leorosie/QSSI-AWS/doc/system overview/overview.odt

# Microcontroller

## Overview:

The microcontroller for this project is an ESP32 chip on a Sparkfun ESP32 Thing version 1.0 development board. Its inputs, outputs, and internal states are controlled through a state pattern. Many of the microcontroller’s features (like I2C, non-volatile storage, and low-power operation) are used. Some features of the microcontroller were not appropriate or adequate for this project and had to be worked around. Further, the development board required physical modifications to meet the needs of the project. More information can be found below and in the `doc/schematic/` and `doc/board\ modifications/` directories.

## State Model:

The software uses a modified gang-of-four (GoF) state pattern where the system’s state is controlled by a PowerState object which is then passed between functions in the application’s core logic. This differs from the original GoF state pattern in that the context is not owned by a particular object, but shared by a few functions. The state may be modified by calling methods of this object which enable and disable power buses, engage and release chip select lines, and change power saving modes in the ESP32 itself. More information can be found in the software documentation.

### Basic State:

Most of the system’s PowerState configurations are based upon its ‘basic state’ where the chip is fully operational but no power buses are engaged nor are any chip select lines engaged. This serves as the basis for most cases where the system is awake. The system states that make use of this state are the SD card access states, the sensor reading states, and the WiFi station state. More information can be found in the `PowerState` software documentation and the `doc/schematic/` directory for hardware details.

#### Sensor Power Bus:

All of the system’s sensors are ‘lifted’ from ground when this bus is not engaged, ensuring they do not draw power except when needed. This is controlled by GPIO pulling up on Q1, and affects the temperature sensor, sonic range sensor, and external ADC.

#### SD Card Power Bus:

The system presently supports two SD cards in the same fashion described for the Sensor Power Bus where each SD card is controlled by pulling up on one of Q2 or Q3.

### Sleep State:

The system spends most of its time asleep, so this state is very important to the project. The PowerState will ensure that all auxiliary power buses and chip selects are disengaged and that the appropriate protocols for waking up are in place before entering this low power state. More information can be found in the `PowerState` software documentation.

## Microcontroller Resources:

Numerous resources provided by the microcontroller and its development board are used by the project. Developers seeking to modify or add to the project must be mindful of existing hardware before they make any changes.

### GPIO:

Numerous general purpose input/output (GPIO) pins are used to switch power rails on and off, act as chip selectors, communicate with sensors through specialized libraries, act as listeners for wake signals, and more. Detailing all of their uses is beyond the scope of this section so the reader is encouraged to examine the software documentation of `pins.h`.

### I2C:

The Inter-integrated circuit (I2C) lines on the microcontroller are used to communicate with a ZS-042 Real Time Clock (RTC) module, which wakes the system from sleep to take readings from sensors. This system is therefor central to the project’s success. More information can be found in the `RTC_container` software documentation.

### SPI:

The Serial Peripheral Interface (SPI) lines on the microcontroller are used to communicate with the external analog to digital converter (ADC) and the Secure Digital (SD) card readers. In addition, several additional GPIO pins are used by this system as chip selector (CS) pins; these CS pins are pulled-down as needed by the PowerState as different SPI systems are connected to power buses.

### NVS:

The ESP32 microcontroller has a section of on-board flash memory that is accessible by software. This Non-volatile Storage (NVS) is used as a temporary storage space for the system so that data collected by sensors need not immediately be sent to SD cards. The energy cost to activate and write to an SD card is non-trivial, so by using NVS to store data for several hours between writes, significant improvements in power consumption are made. More information on this subsystem can be found in the `NVS_container` software documentation.

### WiFi:

The ESP32 microcontroller has a built-in WiFi system that enables both client and station operation. This project enables a WiFi access point station when the WiFi button is used to wake the system; a simple web server then hosts data from the NVS for a client to connect and view. This is a very experimental feature of the project that likely will not be used in the field due to its prohibitive power consumption (even in short uses) but it could conceptually be used to verify the correct operation of the system in the field. Details on this subsystem can be found in the `Wifi_container` software documentation.

### Deep Sleep (power saving modes):

The ESP32 microcontroller is capable of turning off major portions of its circuitry in order to conserve power. This project hinges on such functionality. When in deep sleep, the system’s current consumption has been measured at 85 μA. The system will wake up when it receives a signal from the external RTC or one of the buttons is pressed. The description of these wakeup signals can be found in the `PowerState` enter sleep method.

## ESP32 Issues and workarounds:

### Overview:

The ESP32 is a fairly new contender in the world of microcontrollers and it is very easy to run afoul of its development process. The code is undergoing continuous changes and new chip errata are being uncovered and solved. Some features required for this project couldn’t be obtained from the microcontroller (or needed considerable efforts to use) and documenting these issues may be helpful to future developers in understanding the rationale behind this system’s design and engineering. Specifically, the project required an external ADC, an external RTC, and modifications to the development board.

### On-board ADC:

The ADCs on-board the ESP32 do not have the linear response desired of such devices. While they have improved considerably- even over the short development cycle of this project- they still do not precisely map a range of inputs to a range of outputs in a linear fashion! The fix for this was, as briefly mentioned above, to include an external ADC module. More on this can be found in the `Pyranometer` section below and in the software documentation for the `PyranometerSensor`.

### On-board RTC:

The RTC built in to the ESP32 is not sufficiently accurate for this project. The currently-supported 150 kHz on-board crystal may drift by up to 10% of value and any on-board RTC may require additional circuitry to remain powered on in deep sleep (see https://forum.pycom.io/topic/1069/accuracy-of-rtc for more information). Therefor, the simplest answer is to offload this work to an external RTC with known accuracy and power consumption like the DS3231 integrated circuit on board the ZS-042 module. Details on the use of this module can be found in the `RTC_container` software documentation.

### Development Board Errata:

The Sparkfun ESP32 Thing development board is not prepared to capitalize on the full benefits of deep sleep by default. By referencing an ESP32 forum, the development board was successfully modified to reach a more agreeable power consumption. Details on the exact changes made and a link to this forum post may be found in `doc/board\ modifications`.

## Wiring:

A full schematic of the project can be found in the `doc/schematic/` directory and a simple diagram showing the wiring of sensors inside the enclosure to the prototype board is included as well.

# Sensors:

## Overview:

The microcontroller contains three different sensors: Matix DS1820B temperature sensor, HRXL-MaxSonar-WRS Ultrasonic Snow Depth Sensor, and Apogee SP-110 pyranometer. Frost remains a large source of error for all devices. The pyranometer and ultrasonic sensor are mounted on a 1 meter arm away from the mounting equipment. Electronic housing is vital for all sensors.

## Temperature Sensor:

The DS1820B works using two bandgap-generated voltage sources. One voltage changes across temperature while the other voltage has a low-temperature coefficient and does not change. An ADC then converts the difference of the voltages using a dual-oscillator topology. The temperature sensor communicates to the ESP32 via 1-Wire bus. A pull up resistor is required of approximately 5 kilo ohms. The sensor requires a 3.3 V supply which draws a 1.5 mA current. It is vital for the temperature sensor to be enclosed in housing in order to protect it from solar radiation and wind. The DS1820B operates to a temperature as low as -55 C. The 1-Wire protocol uses a single bus master to control the DS1820B slave. Since there is only one temperature sensor in the unit this system is referred to as a “single-drop” system. Data is transmitted least significant bit via 1-Wire.

## Ultrasonic Sensor:

The ultrasonic rangers measures distance which can be used to calculate the accumulation rate of the Greenland Ice Sheet. The sensor uses a high frequency sound to measure the time for the sound to be transmitted and reflected back. The ESP32 then reads a pulse width outputted by the sensor which represents the distance with a scale factor of 1 uS per mm. The sensor needs a 3.3 V supply which draws 2.3 mA of current. This sensor is specifically built to be used in cold and snowy conditions. The sensor must be mounted away from any objects or large towers, therefore the sonic ranger has been mounted on an arm that is approximately 1 meter away from the mounting equipment. It is also important for the sonic ranger to remain level and be at least 1 meter off the ground in order to supply accurate readings. Other potential sources of error are frost and blowing snow.

## Pyranometer:

The pyranometer measures global shortwave solar radiation. The SP-110 uses a silicon cell detector. This is built around a silicon photodetector which produces a current proportional to the amount of sunlight. A load resistor is required to measure the flow of electrons which is proportional to the sunlight falling on the detector. This is proportional to Ohms law. This pyranometer has a mV range of 0-350 but is only sensitive to 350-1100 nm of the solar spectrum (approximately 80% of the total shortwave radiation). It is self powered and can work to as low as -40 C and can be submerged in water up to depths of 30 m. The measured mV signal must be multipled by a calibration factor of 5.0 W m⁻² per mV in order to obtain the shortwave radiation in W m⁻². The ESP32 has a nonlinear ADC therefore an external ADC was needed. Additionally, due to the low voltage range outputted by the pyranometer an operational amplifer is needed in order to read the signal. This is attached on a daughter board to the pyranometer. The MCP3004 is used as the external ADC and the lm324n is used as the operational amplifier. A drawback to the lm324n is that it only operates to temperatures as low as 0 C. The operational amplifier also adds a gain to the noise, therefore a steady reading is seen even when there is no solar radiation present, this is accounted for in the code. The pyranometer can read as a differential voltage or single voltage, here the differential voltage is used on the operational amplifier and single voltage is used on the external ADC. A reference voltage of 3.3 V was used in order to account for nonlinearity seen in lower reference voltages. The drawbacks of the higher reference voltage is a larger range in outputs for small differences. The pyranometer must be level and oriented with the cable pointing to true north when in use. The SP-110 contains a level on the sensor. Cloudy skies can increase errors by approximately 9.6% due to the fact the sensor was calibrated in clear sky conditions. It should be noted that the current system of measurement needs to be extensively tested more in order to ensure that readings are accurate.

# Connectivity:

## Overview:

This project has built in Wi-fi that allows the user to quickly identify the last measurements from each sensor to ensure the system is working. Due to the final use of the project this connectivity will not be used in the field.

## Wi-fi Connectivity:

The purpose of the connectivity addition is to provide proof to the user that the microcontroller is working and taking reasonable measurements. A built in button may be pressed which wakes up the station and creates a wi-fi hot spot that a user can connect to and navigate to the following IP address: 192.168.4.1. The ssid is “QSSI-AWS” and the password is “12345678”. The user will then see on their smart device each reading that was last taken from the NVS as well as the current time. The drawbacks include that the wi-fi requires an external power supply in order to work sufficiently therefore this function will not be used in the field. More information can be found in the software documentation.

# System Errata:

### Overview:

The system still has a few outstanding issues which could not be resolved to satisfaction in the available time. Some of these issues are not significant in the normal operation of the system but should be kept in consideration by future developers of the project. The known issues are as follows:

### RTC draws more power than needed:

The external RTC is presently connected to the system’s power rails. In the original specification, the RTC would be self-powered by its on-board button cell battery. This does not work because the Sparkfun ESP32 Thing does not pull-up on the I2C lines while it is in deep sleep. There are two practical solutions to this problem:

1. Install pull up resistors on the SCL and SDA lines to the external RTC, cut the VCC line to the external RTC, and install its button cell battery. Values between 4k7 and 10k ohms should prove adequate.
2. Modify the ZS-042 external RTC module to reduce power consumption. This involves disconnecting its and possible modification of its power circuitry.

### Dual/multi SD card operation is disabled:

For purposes of testing, only one SD card is currently supported. It was necessary to remove the previous two SD card readers due to faulty operation on the SPI lines and install another, more friendly unit. This unit is also not ideal due to its operation without level-shifting functionality. To resolve these issues, the developers should:

1. Remove the current SD card module.
2. Install the new SD card modules (Sparkfun level-shifting microSD card readers) using the provided buses. Mechanical support should be taken into account in this process.
3. Re-enable the second SD card module in the system’s software. The necessary calls can be found in the `main.cpp` software documentation.

### Pyranometer output scaling needs verification:

At present, the pyranometer output should not be trusted to accurately relate the perceived intensity of shortwave radiation in its prescribed units of W/m². In addition to uncertainty in the accuracy of the instrument, the circuitry which amplifies and digitizes the output (operational amplifier and ADC) should be scrutinized before field deployment. Further, it would be beneficial to switch to using the ESP32’s on-board ADC as soon as the performance of the unit is fixed by patch to firmware (e.t.a. unknown; check with esp32-idf developer releases for more information). To resolve these issues, the developers should:

1. Send a preferred pyranometer to its manufacturer for calibration and testing.
2. Verify that the calibrated pyranometer delivers the expected output (0V in darkness, 0.25V at solar zenith in summer; results may significantly vary so this is important).
3. Test the operational amplifier’s output voltage for faithful amplification of the pyranometer’s signal from 0~25 mV to 0~325 mV.
4. Verify the ADC’s conversion of the amplified signal from 0~325 mV to 0~1023 (dimensionless integer).

### Wi-fi requires external power supply:

Current use of the wi-fi enabled button requires use of an external power supply in order to efficiently work with the ESP32. Therefore this function will not be used in the field due to power limitations.

### Camera is not ready for installation:

An optional (but encouraged) aspect of this system is a time-lapse camera to take daily snapshots of the system’s environment. At the time of this document’s writing the camera is not assembled nor is its software contained in the project’s repository.

There are several possible ways for this subsystem to interact with existing modules but likely the easiest solution is for the external RTC to send a daily wakeup signal to the system which interprets the signal to engage the self-contained camera module. This reduces the risk of the (non-critical) camera module causing failure in the primary system.
