leorosie/QSSI-AWS/doc/system overview/flowchart.png

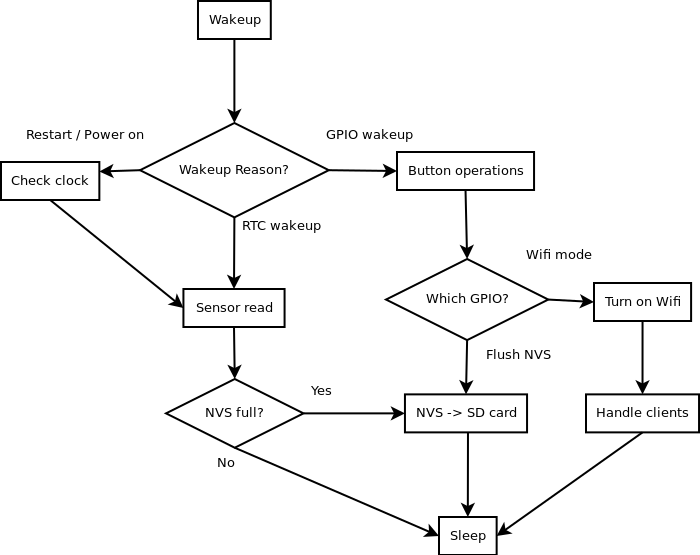
doc/system overview/flowchart.png
