leorosie/QSSI-AWS/doc/schematic/wiring_and_buttons.pdf

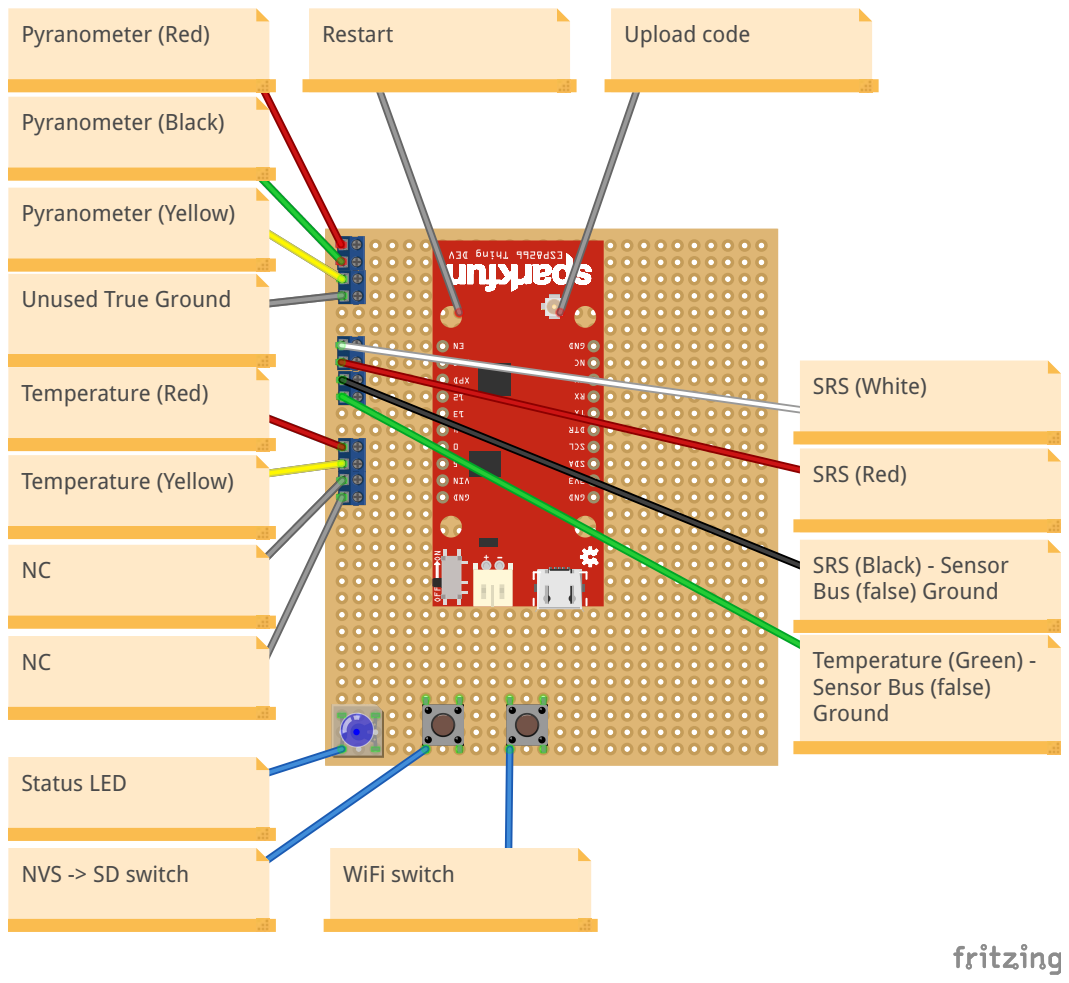
[picture p4: page 1]
Pyranometer (Yellow); Pyranometer (Red); Pyranometer (Black); SRS (White); SRS (Red); Temperature (Red); Temperature (Yellow); Status LED; NVS -> SD switch; WiFi switch; Restart; Upload code

Unused True Ground

SRS (Black) - Sensor
Bus (false) Ground

Temperature (Green) -
Sensor Bus (false)
Ground
