leorosie/QSSI-AWS/doc/schematic/schematic_121217.pdf

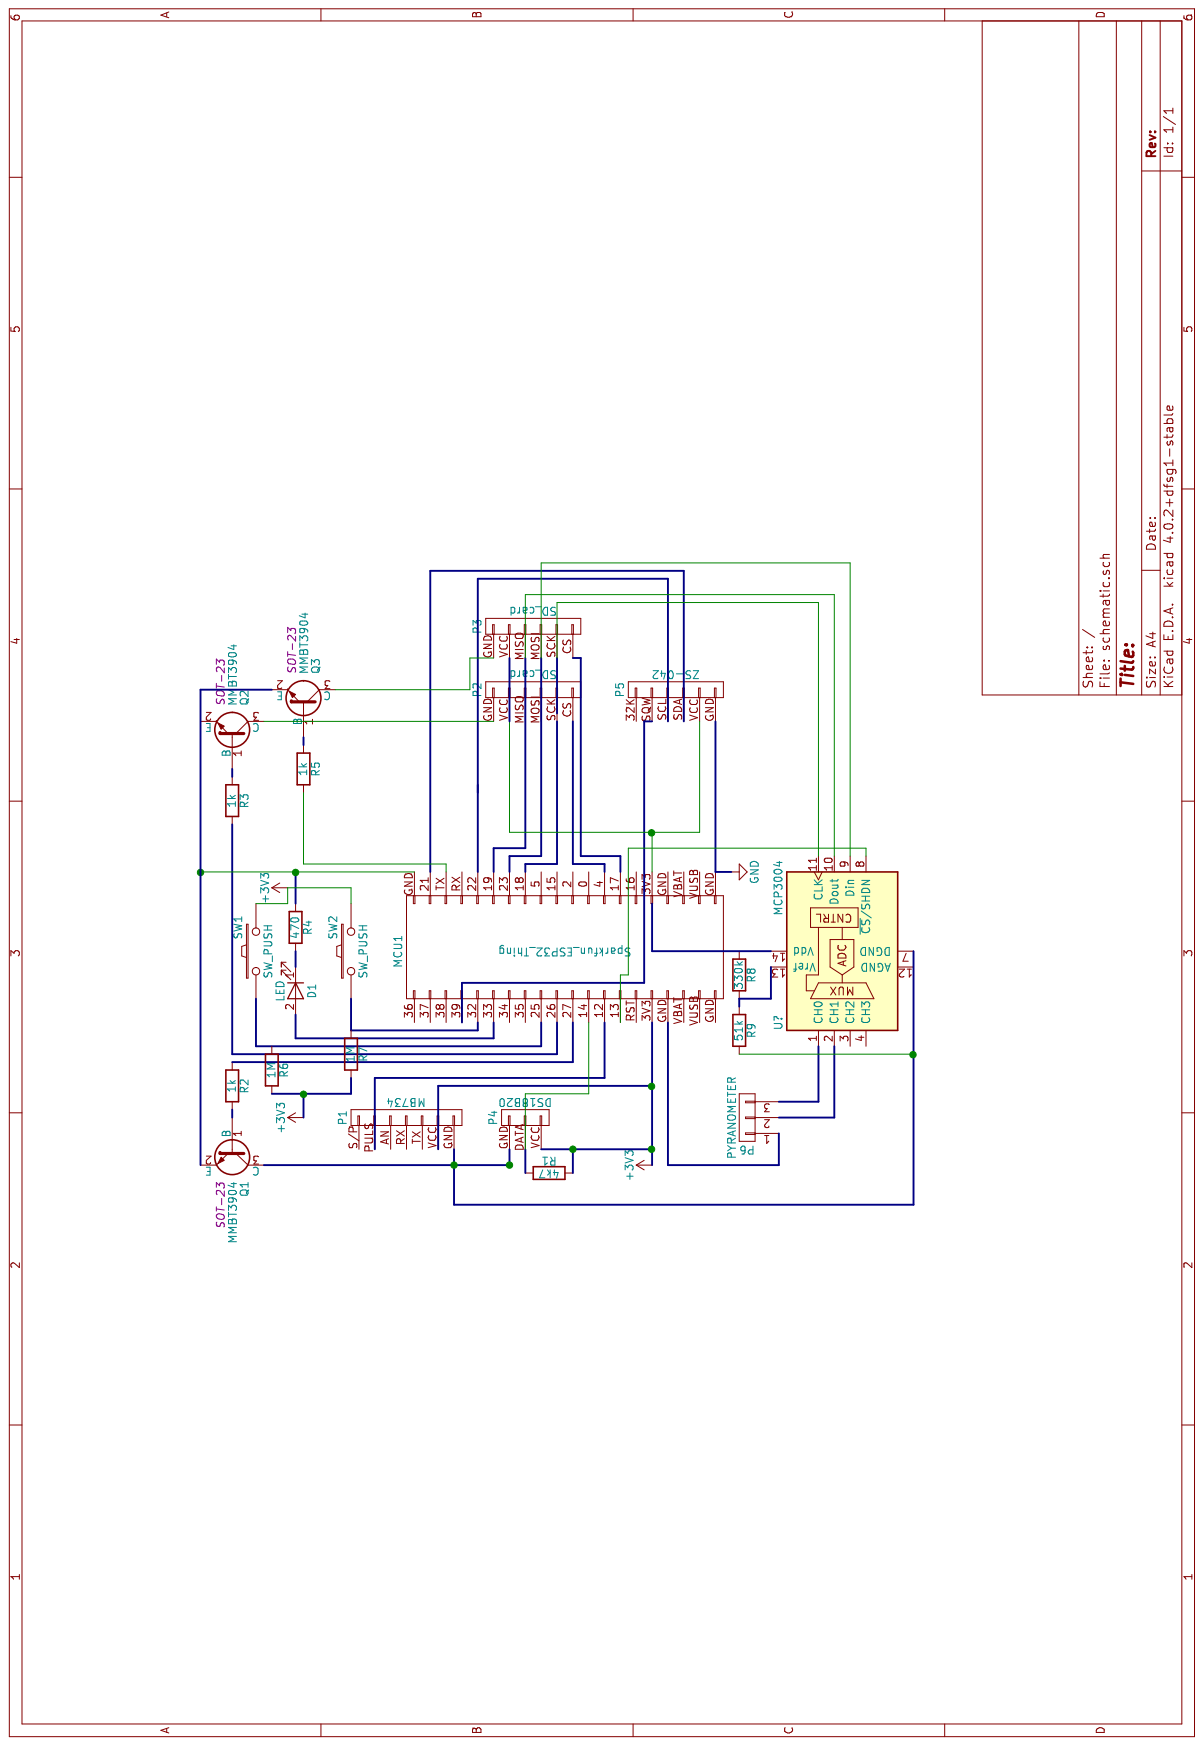
[picture p5: page 1]
