leorosie/QSSI-AWS/doc/schematic/schematic.kicad_pcb

## KiCad design dsky/alarm_indicator/alarm_indicator.kicad_pcb

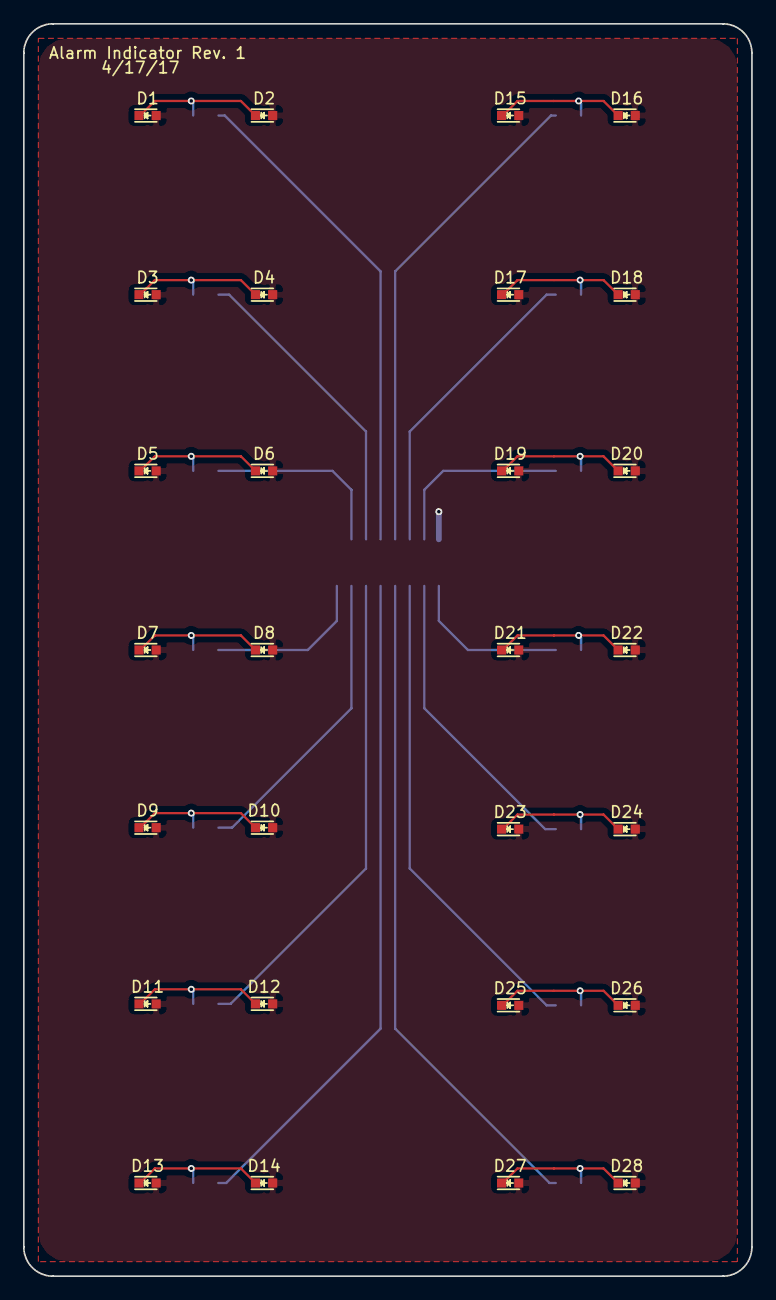
[picture p7: board alarm_indicator.kicad_pcb from above]

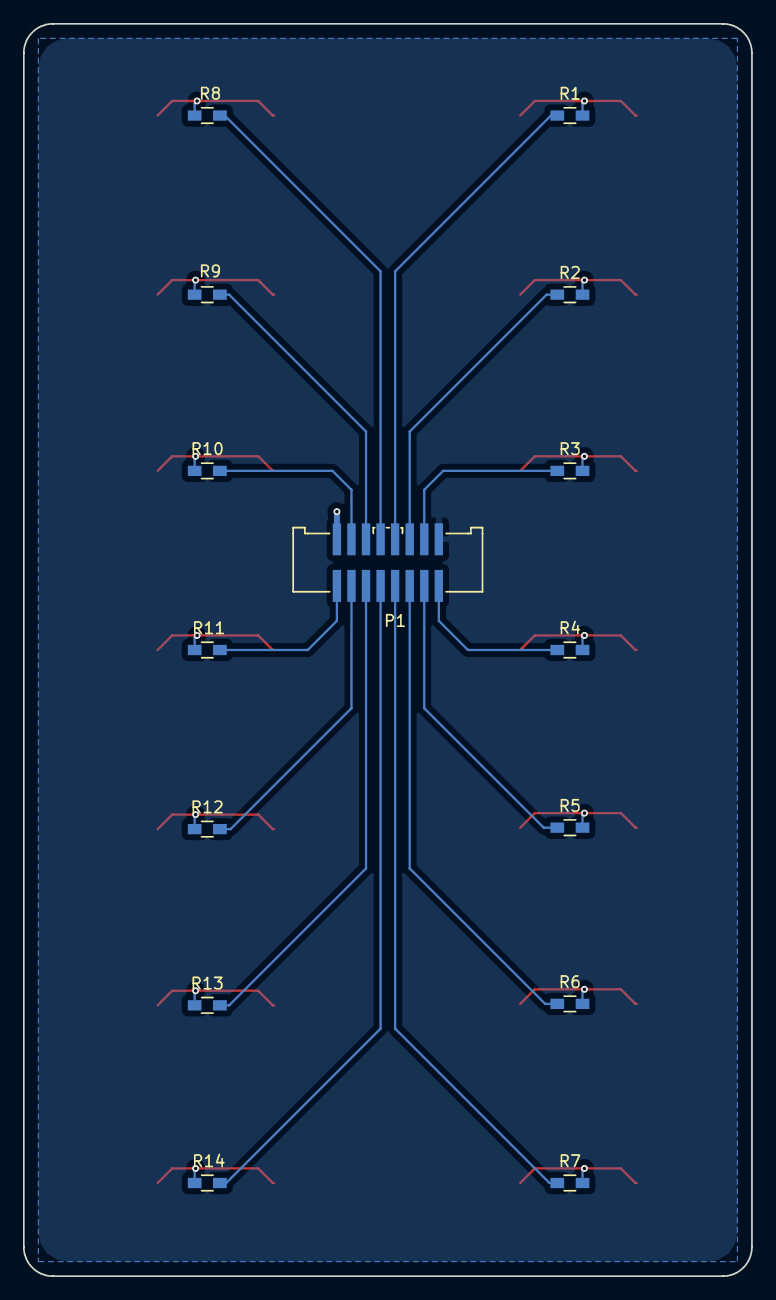
[picture p8: board alarm_indicator.kicad_pcb from below]

Board: 2 copper layers, 63.5 x 109.2 mm, 43 parts (15 on the bottom side), 29 nets.

Parts:
D1, D2, D3, D4, D5, D6, D7, D8, D9, D10, D11, D12, D13, D14, D15, D16, D17, D18, D19, D20, D21, D22, D23, D24, D25, D26, D27, D28: LED; LED-0603
P1: CONN_02X08; SHF-108-01-L-D-SM
R1, R2, R3, R4, R5, R6, R7, R8, R9, R10, R11, R12, R13, R14: 500; R_0603_HandSoldering

Connections:
+12V: D1.2, D2.2, D3.2, D4.2, D5.2, D6.2, D7.2, D8.2, D9.2, D10.2, D11.2, D12.2, D13.2, D14.2, D15.2, D16.2, D17.2, D18.2, D19.2, D20.2, D21.2, D22.2, D23.2, D24.2, D25.2, D26.2, D27.2, D28.2, P1.2
ALT: P1.5, R13.1
GIMBAL_LOCK: P1.6, R9.1
KEY_REL: P1.15, R4.1
NO_ATT: P1.12, R2.1
NO_DAP: P1.9, R7.1
unnamed: D1.1, D2.1, R1.2
unnamed: D3.1, D4.1, R2.2
unnamed: D5.1, D6.1, R3.2
unnamed: D7.1, D8.1, R4.2
unnamed: D9.1, D10.1, R5.2
unnamed: D11.1, D12.1, R6.2
unnamed: D13.1, D14.1, R7.2
unnamed: D15.1, D16.1, R8.2
unnamed: D17.1, D18.1, R9.2
unnamed: D19.1, D20.1, R10.2
unnamed: D21.1, D22.1, R11.2
unnamed: D23.1, D24.1, R12.2
unnamed: D25.1, D26.1, R13.2
unnamed: D27.1, D28.1, R14.2
OPR_ERR: P1.13, R5.1
PRIO_DISP: P1.11, R6.1
PROG: P1.4, R10.1
RESTART: P1.1, R11.1
STBY: P1.14, R3.1
TEMP: P1.8, R8.1
TRACKER: P1.3, R12.1
UPLINK_ACTY: P1.10, R1.1
VEL: P1.7, R14.1
