leorosie/QSSI-AWS/doc/schematic/schematic.kicad_pcb

## KiCad design dsky/digital_indicator/digital_indicator.kicad_pcb

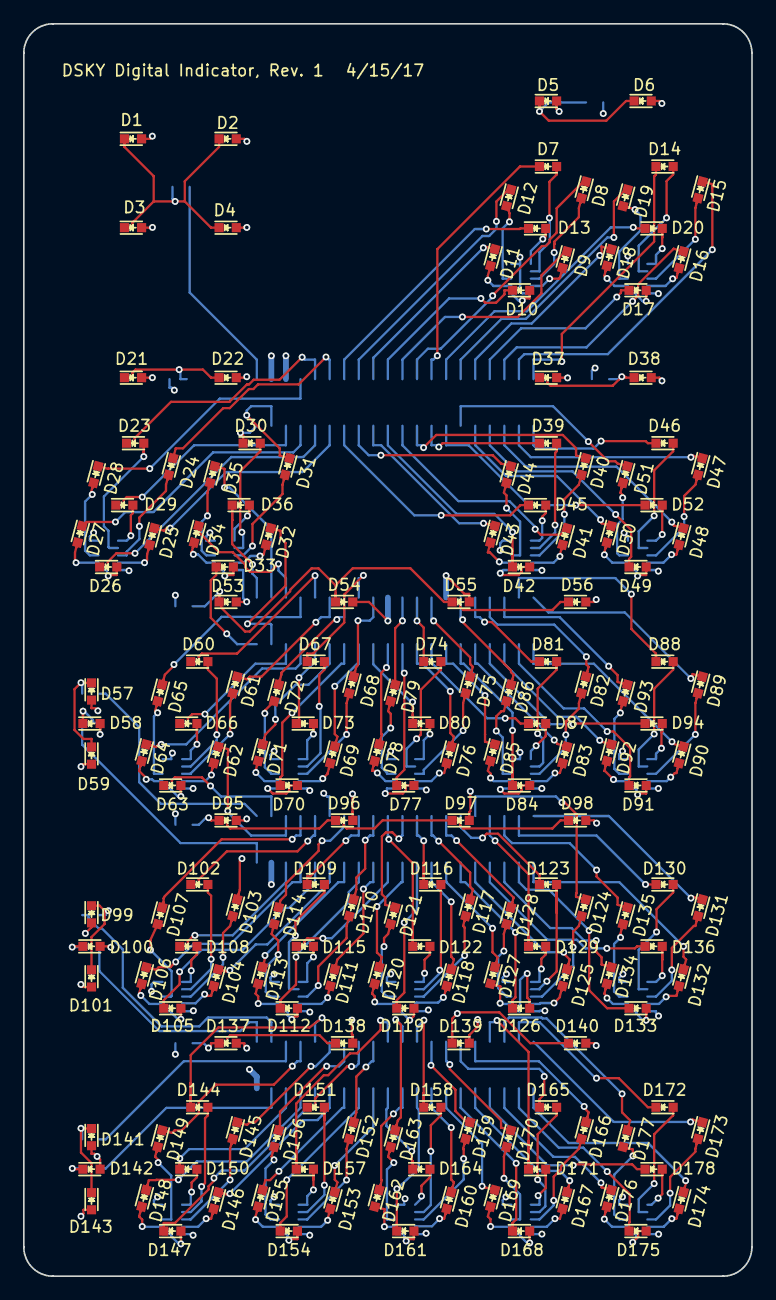
[picture p9: board digital_indicator.kicad_pcb from above]

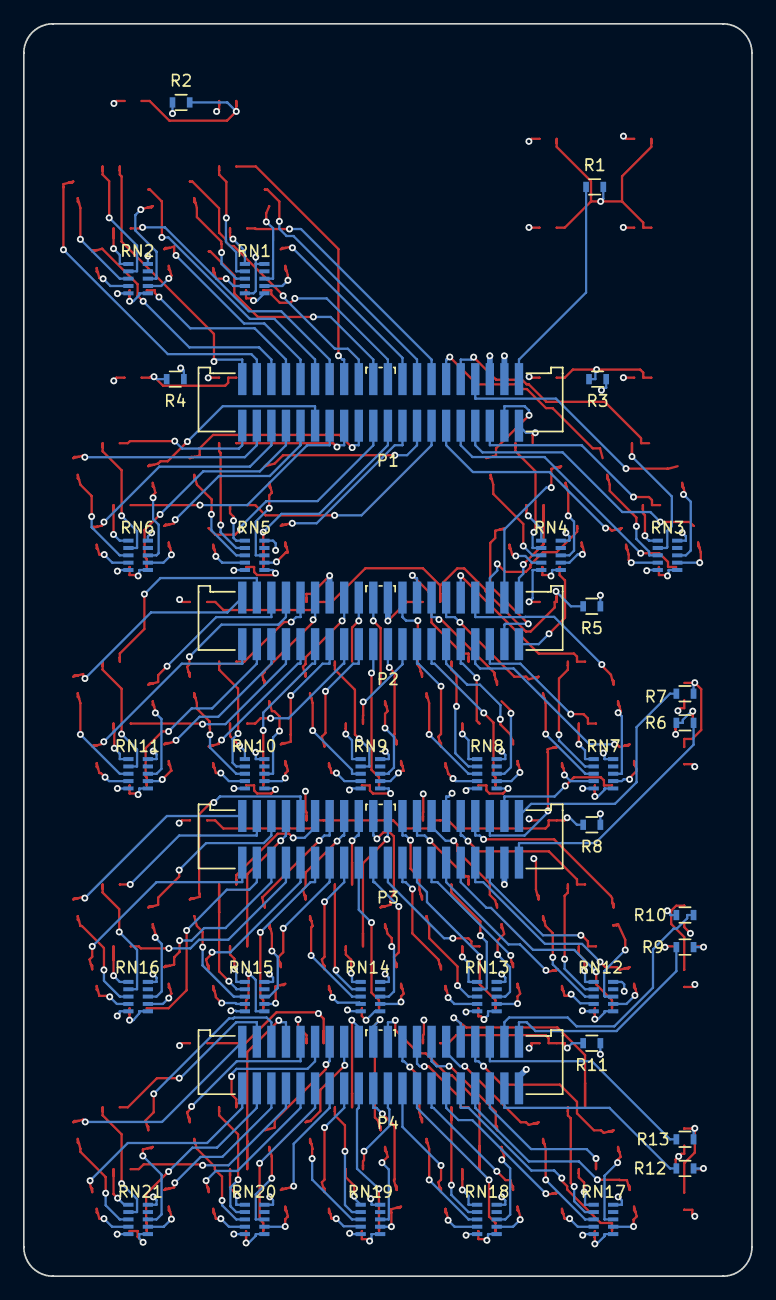
[picture p10: board digital_indicator.kicad_pcb from below]

Board: 4 copper layers, 63.5 x 109.2 mm, 217 parts (38 on the bottom side), 316 nets.

Parts:
D1, D2, D3, D4, D5, D6, D7, D8, D9, D10, D11, D12, D13, D14, D15, D16, D17, D18, D19, D20, D21, D22, D23, D24, D25, D26, D27, D28, D29, D30, D31, D32, D33, D34, D35, D36, D37, D38, D39, D40, D41, D42, D43, D44, D45, D46, D47, D48, D49, D50, D51, D52, D53, D54, D55, D56, D57, D58, D59, D60, D61, D62, D63, D64, D65, D66, D67, D68, D69, D70, D71, D72, D73, D74, D75, D76, D77, D78, D79, D80, D81, D82, D83, D84, D85, D86, D87, D88, D89, D90, D91, D92, D93, D94, D95, D96, D97, D98, D99, D100, D101, D102, D103, D104, D105, D106, D107, D108, D109, D110, D111, D112, D113, D114, D115, D116, D117, D118, D119, D120, D121, D122, D123, D124, D125, D126, D127, D128, D129, D130, D131, D132, D133, D134, D135, D136, D137, D138, D139, D140, D141, D142, D143, D144, D145, D146, D147, D148, D149, D150, D151, D152, D153, D154, D155, D156, D157, D158, D159, D160, D161, D162, D163, D164, D165, D166, D167, D168, D169, D170, D171, D172, D173, D174, D175, D176, D177, D178: LED; LED-0603
G1: LOGO; digital_indicator_outlines
P1, P2, P3, P4: CONN_02X20; SHF-120-01-L-D-SM
R1, R5, R8, R11: 250; R_0603
R2, R3, R4, R7, R10, R13: 500; R_0603
R6, R9, R12: 1k; R_0603
RN1, RN2, RN3, RN4, RN5, RN6, RN7, RN8, RN9, RN10, RN11, RN12, RN13, RN14, RN15, RN16, RN17, RN18, RN19, RN20, RN21: R8_BUSSED; R8_746

Connections:
+12V: D1.2, D2.2, D3.2, D4.2, D5.2, D6.2, D21.2, D22.2, D37.2, D38.2, D53.2, D54.2, D55.2, D56.2, D57.2, D58.2, D59.2, D95.2, D96.2, D97.2, D98.2, D99.2, D100.2, D101.2, D137.2, D138.2, D139.2, D140.2, D141.2, D142.2, D143.2, P1.36, P2.14, P2.22, P3.37, RN1.5, RN1.10, RN2.5, RN2.10, RN3.5, RN3.10, RN4.5, RN4.10, RN5.5, RN5.10, RN6.5, RN6.10, RN7.5, RN7.10, RN8.5, RN8.10, RN9.5, RN9.10, RN10.5, RN10.10, RN11.5, RN11.10, RN12.5, RN12.10, RN13.5, RN13.10, RN14.5, RN14.10, RN15.5, RN15.10, RN16.5, RN16.10, RN17.5, RN17.10, RN18.5, RN18.10, RN19.5, RN19.10, RN20.5, RN20.10, RN21.5, RN21.10
COMACT: P1.40, R1.1
GND: P1.38, P4.39, R2.1, R3.1, R4.1, R5.1, R8.1, R11.1
MD1_A: D7.1, P1.16
MD1_B: D8.1, P1.18
MD1_C: D9.1, P1.20
MD1_D: D10.1, P1.22
MD1_E: D11.1, P1.24
MD1_F: D12.1, P1.26
MD1_G: D13.1, P1.28
MD2_A: D14.1, P1.2
MD2_B: D15.1, P1.4
MD2_C: D16.1, P1.6
MD2_D: D17.1, P1.8
MD2_E: D18.1, P1.10
MD2_F: D19.1, P1.12
MD2_G: D20.1, P1.14
ND1_A: D39.1, P1.15
ND1_B: D40.1, P1.17
ND1_C: D41.1, P1.19
ND1_D: D42.1, P1.21
ND1_E: D43.1, P1.23
ND1_F: D44.1, P1.25
ND1_G: D45.1, P1.27
ND2_A: D46.1, P1.1
ND2_B: D47.1, P1.3
ND2_C: D48.1, P1.5
ND2_D: D49.1, P1.7
ND2_E: D50.1, P1.9
ND2_F: D51.1, P1.11
ND2_G: D52.1, P1.13
unnamed: D1.1, D2.1, D3.1, D4.1, R1.2
unnamed: D5.1, D6.1, R2.2
unnamed: D7.2, RN1.2
unnamed: D8.2, RN1.3
unnamed: D9.2, RN1.4
unnamed: D10.2, RN1.6
unnamed: D11.2, RN1.7
unnamed: D12.2, RN1.8
unnamed: D13.2, RN1.1
unnamed: D14.2, RN2.2
unnamed: D15.2, RN2.3
unnamed: D16.2, RN2.4
unnamed: D17.2, RN2.6
unnamed: D18.2, RN2.7
unnamed: D19.2, RN2.8
unnamed: D20.2, RN2.1
unnamed: D21.1, D22.1, R3.2
unnamed: D23.2, RN3.2
unnamed: D24.2, RN3.3
unnamed: D25.2, RN3.4
unnamed: D26.2, RN3.6
unnamed: D27.2, RN3.7
unnamed: D28.2, RN3.8
unnamed: D29.2, RN3.1
unnamed: D30.2, RN4.2
unnamed: D31.2, RN4.3
unnamed: D32.2, RN4.4
unnamed: D33.2, RN4.6
unnamed: D34.2, RN4.7
unnamed: D35.2, RN4.8
unnamed: D36.2, RN4.1
unnamed: D37.1, D38.1, R4.2
unnamed: D39.2, RN5.2
unnamed: D40.2, RN5.3
unnamed: D41.2, RN5.4
unnamed: D42.2, RN5.6
unnamed: D43.2, RN5.7
unnamed: D44.2, RN5.8
unnamed: D45.2, RN5.1
unnamed: D46.2, RN6.2
unnamed: D47.2, RN6.3
unnamed: D48.2, RN6.4
unnamed: D49.2, RN6.6
unnamed: D50.2, RN6.7
unnamed: D51.2, RN6.8
unnamed: D52.2, RN6.1
unnamed: D53.1, D54.1, D55.1, D56.1, R5.2
unnamed: D57.1, D59.1, R7.1
unnamed: D58.1, R6.1
unnamed: D60.2, RN7.2
unnamed: D61.2, RN7.3
unnamed: D62.2, RN7.4
unnamed: D63.2, RN7.6
unnamed: D64.2, RN7.7
unnamed: D65.2, RN7.8
unnamed: D66.2, RN7.1
unnamed: D67.2, RN8.2
unnamed: D68.2, RN8.3
unnamed: D69.2, RN8.4
unnamed: D70.2, RN8.6
unnamed: D71.2, RN8.7
unnamed: D72.2, RN8.8
unnamed: D73.2, RN8.1
unnamed: D74.2, RN9.2
unnamed: D75.2, RN9.3
unnamed: D76.2, RN9.4
unnamed: D77.2, RN9.6
unnamed: D78.2, RN9.7
unnamed: D79.2, RN9.8
unnamed: D80.2, RN9.1
unnamed: D81.2, RN10.2
unnamed: D82.2, RN10.3
unnamed: D83.2, RN10.4
unnamed: D84.2, RN10.6
unnamed: D85.2, RN10.7
unnamed: D86.2, RN10.8
unnamed: D87.2, RN10.1
unnamed: D88.2, RN11.2
unnamed: D89.2, RN11.3
unnamed: D90.2, RN11.4
unnamed: D91.2, RN11.6
unnamed: D92.2, RN11.7
unnamed: D93.2, RN11.8
unnamed: D94.2, RN11.1
unnamed: D95.1, D96.1, D97.1, D98.1, R8.2
unnamed: D100.1, R9.1
unnamed: D99.1, D101.1, R10.1
unnamed: D102.2, RN12.2
unnamed: D103.2, RN12.3
unnamed: D104.2, RN12.4
unnamed: D105.2, RN12.6
unnamed: D106.2, RN12.7
unnamed: D107.2, RN12.8
unnamed: D108.2, RN12.1
unnamed: D109.2, RN13.2
unnamed: D110.2, RN13.3
unnamed: D111.2, RN13.4
unnamed: D112.2, RN13.6
unnamed: D113.2, RN13.7
unnamed: D114.2, RN13.8
unnamed: D115.2, RN13.1
unnamed: D116.2, RN14.2
unnamed: D117.2, RN14.3
unnamed: D118.2, RN14.4
unnamed: D119.2, RN14.6
unnamed: D120.2, RN14.7
unnamed: D121.2, RN14.8
unnamed: D122.2, RN14.1
unnamed: D123.2, RN15.2
unnamed: D124.2, RN15.3
unnamed: D125.2, RN15.4
unnamed: D126.2, RN15.6
unnamed: D127.2, RN15.7
unnamed: D128.2, RN15.8
unnamed: D129.2, RN15.1
unnamed: D130.2, RN16.2
unnamed: D131.2, RN16.3
unnamed: D132.2, RN16.4
unnamed: D133.2, RN16.6
unnamed: D134.2, RN16.7
unnamed: D135.2, RN16.8
unnamed: D136.2, RN16.1
unnamed: D137.1, D138.1, D139.1, D140.1, R11.2
unnamed: D141.1, D143.1, R13.1
unnamed: D142.1, R12.1
unnamed: D144.2, RN17.2
unnamed: D145.2, RN17.3
unnamed: D146.2, RN17.4
unnamed: D147.2, RN17.6
unnamed: D148.2, RN17.7
unnamed: D149.2, RN17.8
unnamed: D150.2, RN17.1
unnamed: D151.2, RN18.2
unnamed: D152.2, RN18.3
unnamed: D153.2, RN18.4
unnamed: D154.2, RN18.6
unnamed: D155.2, RN18.7
unnamed: D156.2, RN18.8
unnamed: D157.2, RN18.1
unnamed: D158.2, RN19.2
unnamed: D159.2, RN19.3
unnamed: D160.2, RN19.4
unnamed: D161.2, RN19.6
unnamed: D162.2, RN19.7
unnamed: D163.2, RN19.8
unnamed: D164.2, RN19.1
unnamed: D165.2, RN20.2
unnamed: D166.2, RN20.3
unnamed: D167.2, RN20.4
unnamed: D168.2, RN20.6
unnamed: D169.2, RN20.7
unnamed: D170.2, RN20.8
unnamed: D171.2, RN20.1
unnamed: D172.2, RN21.2
unnamed: D173.2, RN21.3
unnamed: D174.2, RN21.4
unnamed: D175.2, RN21.6
unnamed: D176.2, RN21.7
unnamed: D177.2, RN21.8
unnamed: D178.2, RN21.1
R1+: P3.40, R7.2
R1-: P3.39, R6.2
R1D1_A: D60.1, P2.32
R1D1_B: D61.1, P2.30
R1D1_C: D62.1, P3.36
R1D1_D: D63.1, P3.38
R1D1_E: D64.1, P2.33
R1D1_F: D65.1, P2.34
R1D1_G: D66.1, P2.35
R1D2_A: D67.1, P2.26
R1D2_B: D68.1, P2.24
R1D2_C: D69.1, P2.25
R1D2_D: D70.1, P2.27
R1D2_E: D71.1, P2.29
R1D2_F: D72.1, P2.28
R1D2_G: D73.1, P2.31
R1D3_A: D74.1, P2.18
R1D3_B: D75.1, P2.16
R1D3_C: D76.1, P2.17
R1D3_D: D77.1, P2.19
R1D3_E: D78.1, P2.21
R1D3_F: D79.1, P2.20
R1D3_G: D80.1, P2.23
R1D4_A: D81.1, P2.10
R1D4_B: D82.1, P2.8
R1D4_C: D83.1, P2.9
R1D4_D: D84.1, P2.11
R1D4_E: D85.1, P2.13
R1D4_F: D86.1, P2.12
R1D4_G: D87.1, P2.15
R1D5_A: D88.1, P2.4
R1D5_B: D89.1, P2.2
R1D5_C: D90.1, P2.1
R1D5_D: D91.1, P2.3
R1D5_E: D92.1, P2.5
R1D5_F: D93.1, P2.6
R1D5_G: D94.1, P2.7
R2+: P4.38, R10.2
R2-: P4.40, R9.2
R2D1_A: D102.1, P3.32
R2D1_B: D103.1, P3.30
R2D1_C: D104.1, P3.29
R2D1_D: D105.1, P3.31
R2D1_E: D106.1, P3.33
R2D1_F: D107.1, P3.34
R2D1_G: D108.1, P3.35
R2D2_A: D109.1, P3.26
R2D2_B: D110.1, P3.24
R2D2_C: D111.1, P3.23
R2D2_D: D112.1, P3.25
R2D2_E: D113.1, P3.27
R2D2_F: D114.1, P3.28
R2D2_G: D115.1, P3.21
R2D3_A: D116.1, P3.18
R2D3_B: D117.1, P3.16
R2D3_C: D118.1, P3.15
R2D3_D: D119.1, P3.17
R2D3_E: D120.1, P3.19
R2D3_F: D121.1, P3.20
R2D3_G: D122.1, P3.22
R2D4_A: D123.1, P3.12
R2D4_B: D124.1, P3.10
R2D4_C: D125.1, P3.9
R2D4_D: D126.1, P3.11
R2D4_E: D127.1, P3.13
R2D4_F: D128.1, P3.14
R2D4_G: D129.1, P3.8
R2D5_A: D130.1, P3.4
R2D5_B: D131.1, P3.2
R2D5_C: D132.1, P3.1
R2D5_D: D133.1, P3.3
R2D5_E: D134.1, P3.5
R2D5_F: D135.1, P3.6
R2D5_G: D136.1, P3.7
R3+: P4.36, R13.2
R3-: P4.37, R12.2
R3D1_A: D144.1, P4.32
R3D1_B: D145.1, P4.30
R3D1_C: D146.1, P4.29
R3D1_D: D147.1, P4.31
R3D1_E: D148.1, P4.33
R3D1_F: D149.1, P4.34
R3D1_G: D150.1, P4.35
R3D2_A: D151.1, P4.26
R3D2_B: D152.1, P4.24
R3D2_C: D153.1, P4.23
R3D2_D: D154.1, P4.25
R3D2_E: D155.1, P4.27
R3D2_F: D156.1, P4.28
R3D2_G: D157.1, P4.22
R3D3_A: D158.1, P4.18
R3D3_B: D159.1, P4.16
R3D3_C: D160.1, P4.15
R3D3_D: D161.1, P4.17
R3D3_E: D162.1, P4.19
R3D3_F: D163.1, P4.20
R3D3_G: D164.1, P4.21
R3D4_A: D165.1, P4.12
R3D4_B: D166.1, P4.10
R3D4_C: D167.1, P4.9
R3D4_D: D168.1, P4.11
R3D4_E: D169.1, P4.13
R3D4_F: D170.1, P4.14
R3D4_G: D171.1, P4.8
R3D5_A: D172.1, P4.4
R3D5_B: D173.1, P4.2
R3D5_C: D174.1, P4.1
R3D5_D: D175.1, P4.3
R3D5_E: D176.1, P4.5
R3D5_F: D177.1, P4.6
R3D5_G: D178.1, P4.7
VD1_A: D23.1, P1.32
VD1_B: D24.1, P1.30
VD1_C: D25.1, P1.29
VD1_D: D26.1, P1.31
VD1_E: D27.1, P1.33
VD1_F: D28.1, P1.34
VD1_G: D29.1, P1.35
VD2_A: D30.1, P1.39
VD2_B: D31.1, P1.37
VD2_C: D32.1, P2.37
VD2_D: D33.1, P2.39
VD2_E: D34.1, P2.36
VD2_F: D35.1, P2.38
VD2_G: D36.1, P2.40
