leorosie/QSSI-AWS/src/SonicRangeSensor.cpp

#include "SonicRangeSensor.h"


int8_t SonicRangeSensor::setup(){
  int8_t status = 0;
  pinMode(SONIC_RANGER_BUS, INPUT);
  return(status);
}

//TODO: add long->byte[] casting in utils.h and use here!
uint8_t SonicRangeSensor::read(uint8_t* address){
  uint8_t len;
  long pulse_value = pulseIn(SONIC_RANGER_BUS, HIGH);
  Serial.println(pulse_value);
  len = long_to_bytes(address,pulse_value);
  return(len);
}
