leorosie/QSSI-AWS/(commit log)

2017-10-20 initial project code; has basic RTC functionality, some temperature sensor configuration, some snow depth configuration, deep sleep, etc.
2017-10-26 starting with getting latest sleep changes in; next: actual refactor into multiple files and a sensor inheritance hierarchy
2017-10-26 broke out the temperature sensor using an abstract sensor class; still need to finish documenting the methods it contains. it compiled just fine but we should try to run this code with the sensor to 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
    [AbstractSensor.h, TemperatureSensor.cpp, TemperatureSensor.h, main.cpp]
2017-10-26 Commented up the temperature sensor code and fixed some minor mistakes; noted another potential issue our AbstractSensor class gives us.
    [AbstractSensor.h, TemperatureSensor.cpp, TemperatureSensor.h, main.cpp]
2017-10-26 added class files for sonic range sensor. still want to encapsulate the real time clock but this will be a little different since it's not a sensor
2017-10-26 the code is now in many smaller files. i will test it for correctness soon.
    [RTC_container.cpp, RTC_container.h, main.cpp]
2017-10-27 further restructuring and commenting; still need to examine that abstract sensor method.
2017-11-02 data output refactor in process (and looking good); temperature sensor working as expected; RTC working as expected; sonar sensor very close; now testing sonar from higher location
2017-11-05 RTC can now sleep for variable periods of time (either alarm should work) but i need to clean up some print statements, documentation, and signatures. also may want to move the timer's increment to m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
2017-11-16 atom bugged and messed up rebase
    [RTC_container.cpp]
2017-11-16 fixed up the data buffer in main and tested (looks ok)
    [RTC_container.cpp, main.cpp]
2017-11-16 added all pins in use on prototype
2017-11-16 added a simple state system to the project; seems like our special ground messes with temp sensor (gdi)
2017-11-20 fixed up the temperature sensor read() method to work with power states; once we test it and the SRS it's ready to merge
    [TemperatureSensor.cpp, TemperatureSensor.h, main.cpp]
2017-11-20 added pdf of schematic (will add all sch files later)
2017-11-21 both temp and srs work ok; still need to modify board with pullup resistors for other wakeup pins
2017-11-21 Correct pyranometer code and byte to long conversion
    [PyranometerSensor.cpp, PyranometerSensor.h, main.cpp, pins.h]
2017-11-26 fixed typo in main.cpp
    [main.cpp]
2017-12-01 current SD card version should support at least one card...?
2017-12-06 current build works pretty much as intended; still need to resolve a couple integration bugs but we're close to done.
    [PowerState.cpp, RTC_container.cpp, SD_container.cpp, SD_container.h, main.cpp, main.h, pins.h]
2017-12-06 button wake-ups now work using ext1 (any high) and register a RTC_CNTL wakeup
2017-12-12 some documentation added
    [schematic.kicad_pcb, schematic.sch]
2017-12-12 added a bunch to the docs. tired of writing so here's what we got so far.
2017-12-13 added a wiring diagram and wrapped up most of the overview document
